anthonylhill/PiLoader/Photos/PCB.jpg

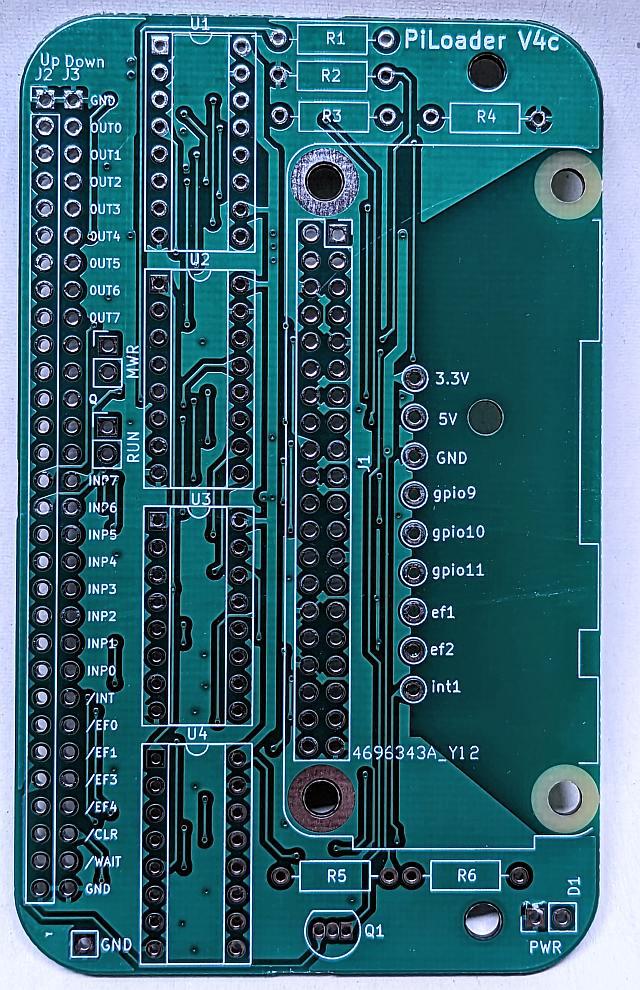
Photos/PCB.jpg
