anthonylhill/PiLoader/Photos/localmode.jpg

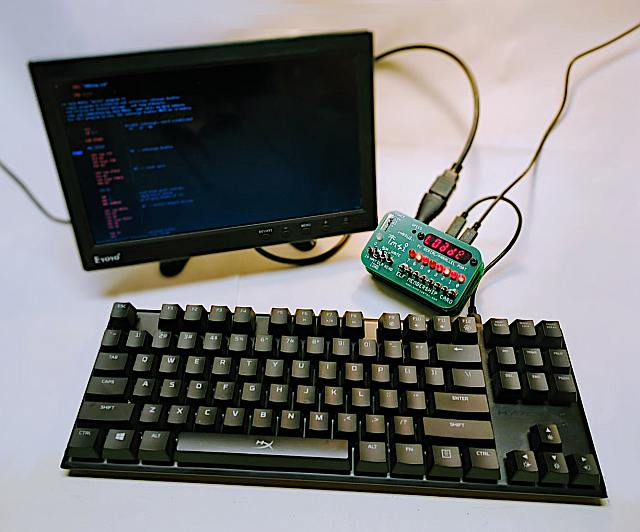
Photos/localmode.jpg
