anthonylhill/PiLoader/README.md

# PiZero Adapter for Lee Hart's Membership Card
### Project Web Page :  [ http://anthonylhill.github.io ](http://anthonylhill.github.io)
<table> 
    <tr>
        <td>System</td><td>Lee Hart's Membership Card</td>
    </tr>    
    <tr>
        <td>Processor</td><td>CDP1802 1.8 or 4 MHz</td>
    </tr>
    <tr>
        <td>Raspberry Pi</td><td>Zero,  Zero W, Zero 2 W</td>
    </tr>
    <tr>
        <td>Software</td><td>1802 Loader Program</td>
    </tr>
</table>

Software README.TXT :   https://github.com/anthonylhill/PiLoader/blob/main/Software/README.TXT </br>
<B>Tags</B> : CDP1802 eclectic retro mishmash fusion retro-futurism anachronism
