anthonylhill/PiLoader/Photos/CPUonly.jpg

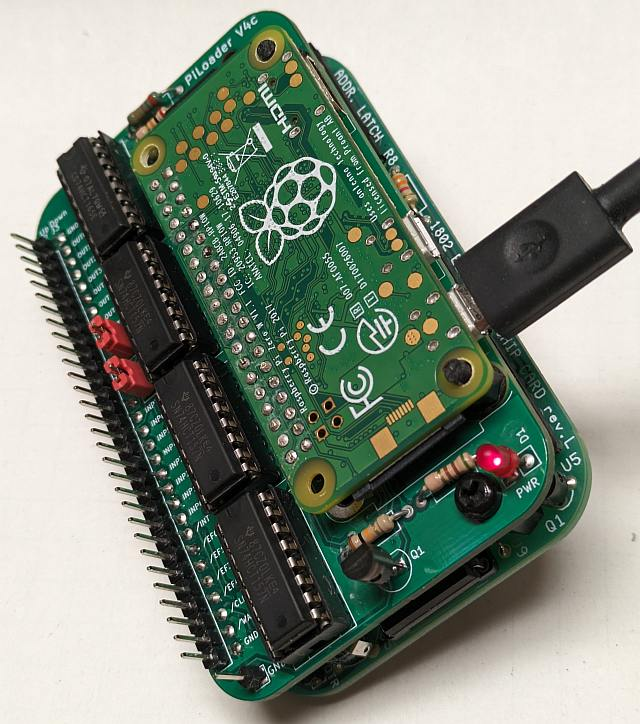
Photos/CPUonly.jpg
