anthonylhill/PiLoader/Photos/Front.jpg

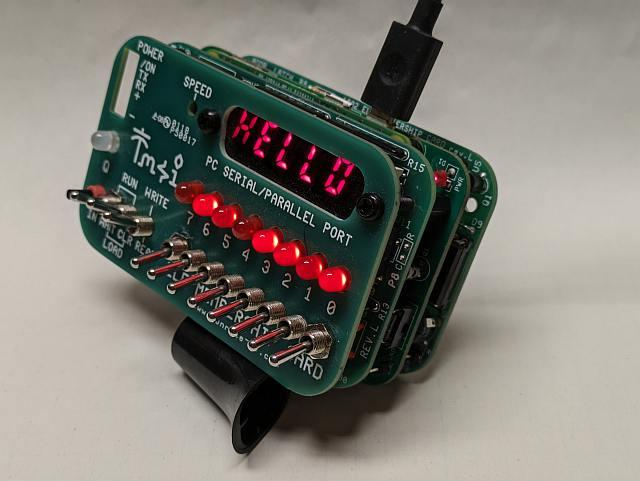
Photos/Front.jpg
