anthonylhill/PiLoader/Photos/screenshot.jpg

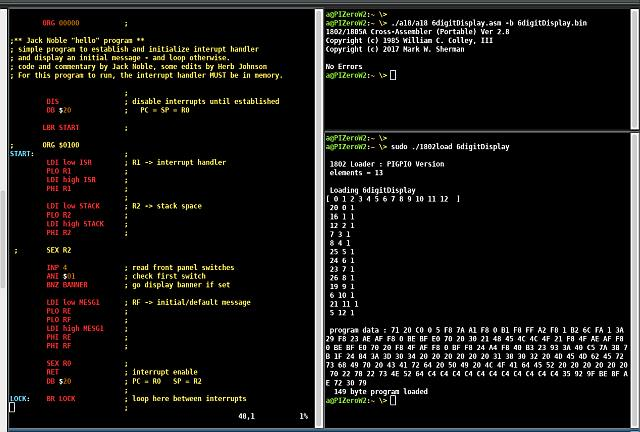
Photos/screenshot.jpg
