anthonylhill/PiLoader/Photos/Side.jpg

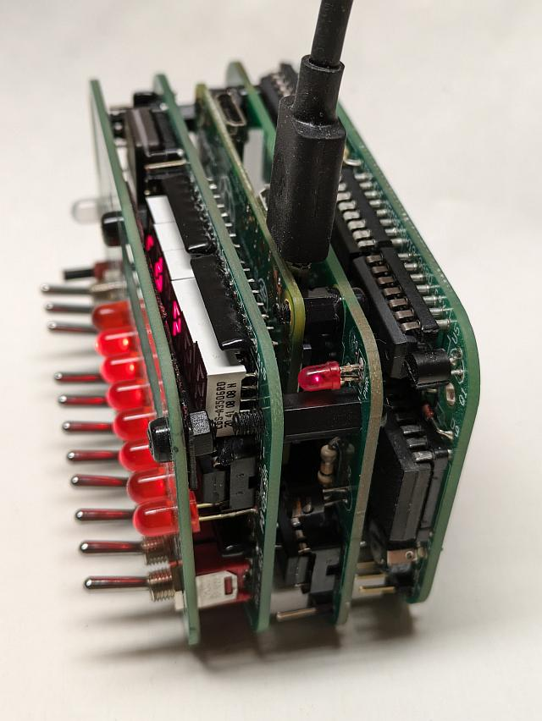
Photos/Side.jpg
