anthonylhill/PiLoader/Photos/TopView.jpg

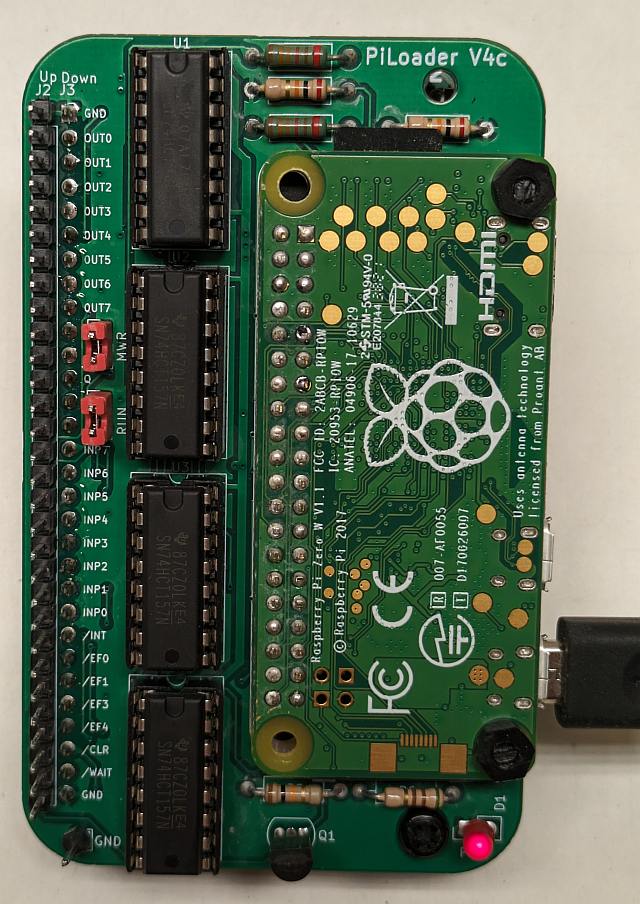
Photos/TopView.jpg
