anthonylhill/PiLoader/schematic.pdf

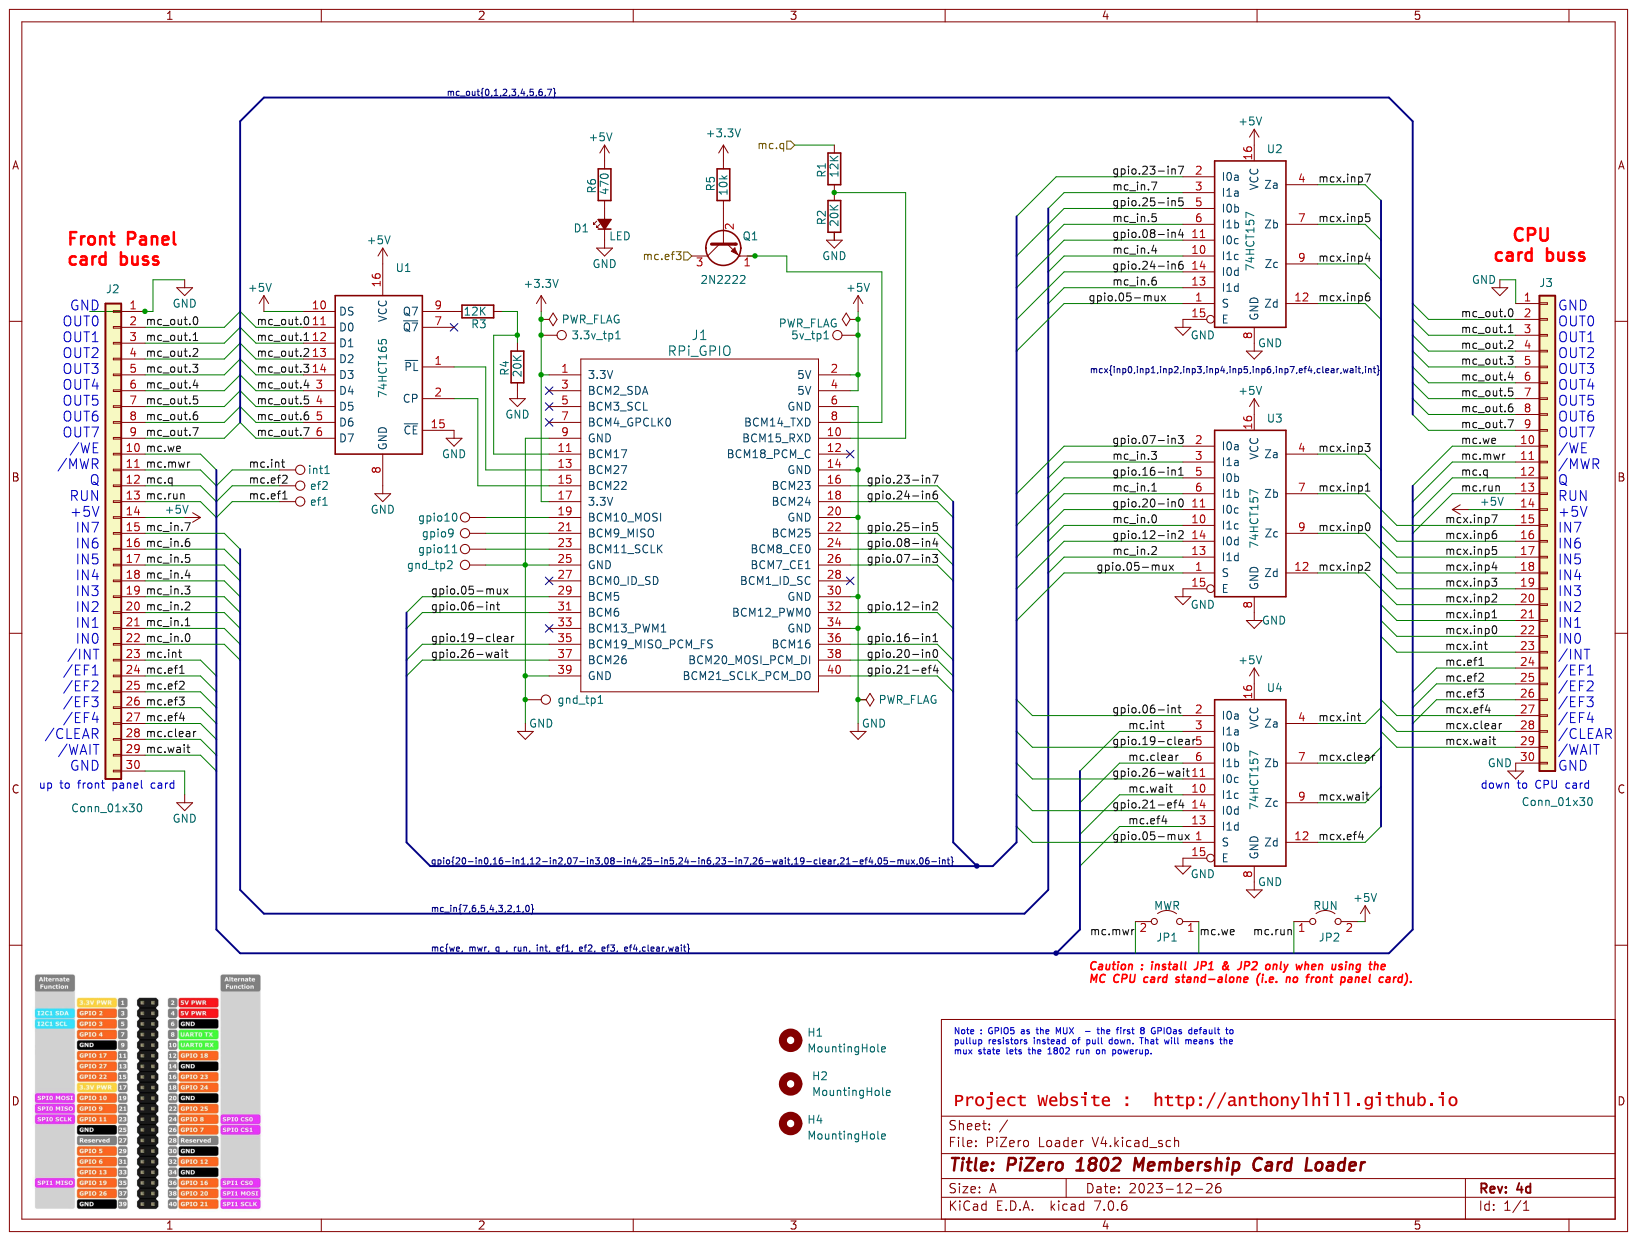
[picture p12: page 1]
