anthonylhill/PiLoader/KiCAD 7.0 Files/PiZero Loader V4.kicad_pcb

## KiCad design KiCAD 7.0 Files/PiZero Loader V4.kicad_pcb (2023-06-16)

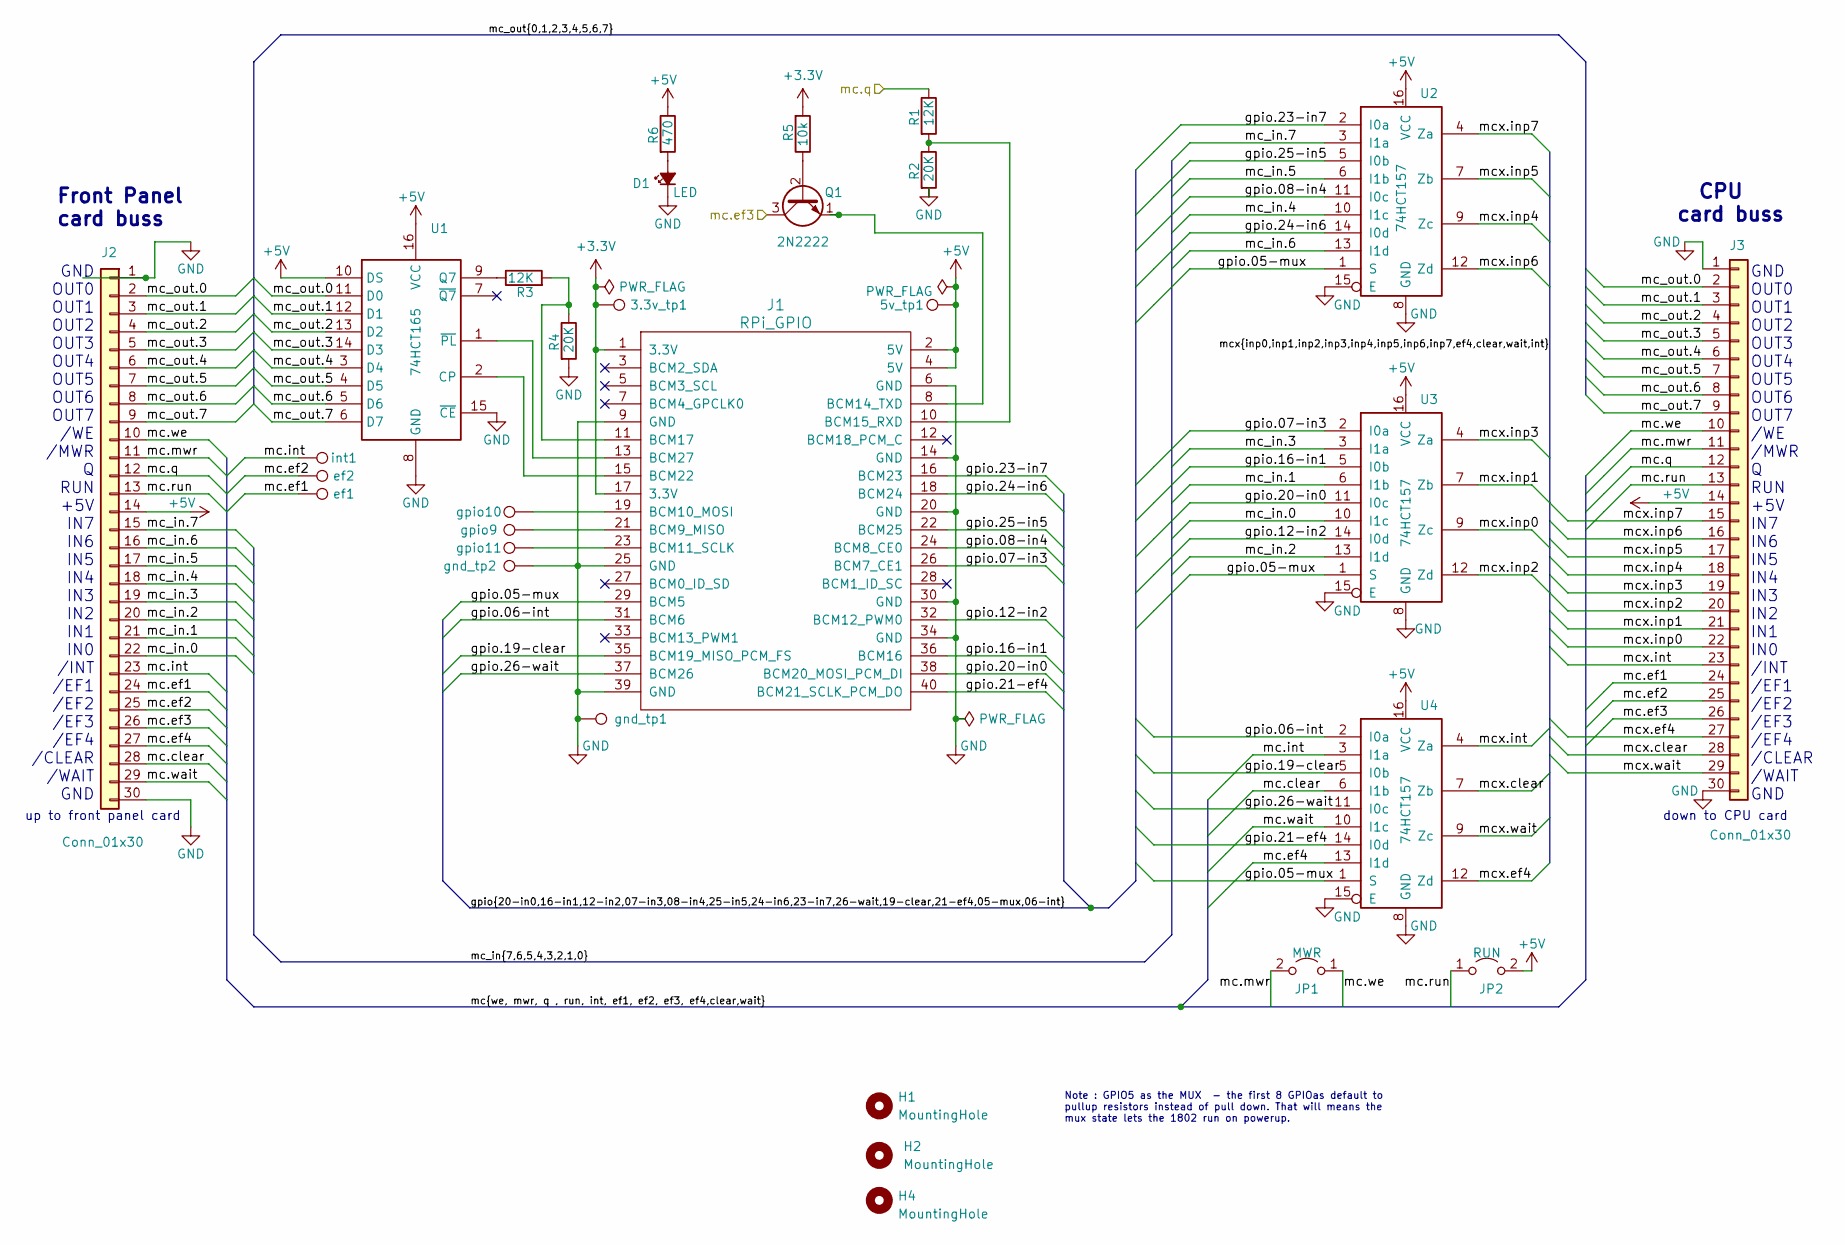
[picture p13: schematic PiZero Loader V4.kicad_sch, PiZero 1802 Membership Card Loader]

Parts:
3.3v_tp1, 5v_tp1: TestPoint; TestPoint_THTPad_D2.0mm_Drill1.0mm
D1: LED; PinHeader_1x02_P2.54mm_Vertical
H1, H2, H4: MountingHole; MountingHole_3.2mm_M3
J1: RPi_GPIO; Raspberry_Pi_Zero_Socketed_THT_FaceDown_MountingHoles
J2: Conn_01x30; PinHeader_1x30_P2.54mm_Vertical
J3: Conn_01x30; PinSocket_1x30_P2.54mm_Vertical
JP1: MWR; PinHeader_1x02_P2.54mm_Vertical
JP2: RUN; PinHeader_1x02_P2.54mm_Vertical
Q1: 2N2222; TO-92_Inline
R1, R3: 12K; R_Axial_DIN0207_L6.3mm_D2.5mm_P10.16mm_Horizontal
R2, R4: 20K; R_Axial_DIN0207_L6.3mm_D2.5mm_P10.16mm_Horizontal
R5: 10k; R_Axial_DIN0207_L6.3mm_D2.5mm_P10.16mm_Horizontal
R6: 470; R_Axial_DIN0207_L6.3mm_D2.5mm_P10.16mm_Horizontal
U1: 74HCT165; DIP-16_W7.62mm_Socket
U2, U3, U4: 74HCT157; DIP-16_W7.62mm_Socket
ef1, ef2: TestPoint; TestPoint_THTPad_D2.0mm_Drill1.0mm
gnd_tp1: TestPoint; TestPoint_THTPad_D2.0mm_Drill1.0mm
gnd_tp2: TestPoint; TestPoint_THTPad_2.0x2.0mm_Drill1.0mm
gpio9, gpio10, gpio11: TestPoint; TestPoint_THTPad_D2.0mm_Drill1.0mm
int1: TestPoint; TestPoint_THTPad_D2.0mm_Drill1.0mm

Connections:
+3.3V: 3.3v_tp1.1, J1.1 (3.3V), J1.17 (3.3V), R5.2
+5V: 5v_tp1.1, J1.2 (5V), J1.4 (5V), J2.14, J3.14, JP2.2 (B), R6.1, U1.10 (DS), U1.16 (VCC), U2.16 (VCC), U3.16 (VCC), U4.16 (VCC)
/gpio.05-mux: J1.29 (BCM5), U2.1 (S), U3.1 (S), U4.1 (S)
/gpio.06-int: J1.31 (BCM6), U4.2 (I0a)
/gpio.07-in3: J1.26 (BCM7_CE1), U3.2 (I0a)
/gpio.08-in4: J1.24 (BCM8_CE0), U2.11 (I0c)
/gpio.12-in2: J1.32 (BCM12_PWM0), U3.14 (I0d)
/gpio.16-in1: J1.36 (BCM16), U3.5 (I0b)
/gpio.19-clear: J1.35 (BCM19_MISO_PCM_FS), U4.5 (I0b)
/gpio.20-in0: J1.38 (BCM20_MOSI_PCM_DI), U3.11 (I0c)
/gpio.21-ef4: J1.40 (BCM21_SCLK_PCM_DO), U4.14 (I0d)
/gpio.23-in7: J1.16 (BCM23), U2.2 (I0a)
/gpio.24-in6: J1.18 (BCM24), U2.14 (I0d)
/gpio.25-in5: J1.22 (BCM25), U2.5 (I0b)
/gpio.26-wait: J1.37 (BCM26), U4.11 (I0c)
/mc.clear: J2.28, U4.6 (I1b)
/mc.ef1: J2.24, J3.24, ef1.1
/mc.ef2: J2.25, J3.25, ef2.1
/mc.ef3: J2.26, J3.26, Q1.3 (C)
/mc.ef4: J2.27, U4.13 (I1d)
/mc.int: J2.23, U4.3 (I1a), int1.1
/mc.mwr: J2.11, J3.11, JP1.2 (B)
/mc.q: J2.12, J3.12, R1.1
/mc.run: J2.13, J3.13, JP2.1 (A)
/mc.wait: J2.29, U4.10 (I1c)
/mc.we: J2.10, J3.10, JP1.1 (A)
/mc_in.0: J2.22, U3.10 (I1c)
/mc_in.1: J2.21, U3.6 (I1b)
/mc_in.2: J2.20, U3.13 (I1d)
/mc_in.3: J2.19, U3.3 (I1a)
/mc_in.4: J2.18, U2.10 (I1c)
/mc_in.5: J2.17, U2.6 (I1b)
/mc_in.6: J2.16, U2.13 (I1d)
/mc_in.7: J2.15, U2.3 (I1a)
/mc_out.0: J2.2, J3.2, U1.11 (D0)
/mc_out.1: J2.3, J3.3, U1.12 (D1)
/mc_out.2: J2.4, J3.4, U1.13 (D2)
/mc_out.3: J2.5, J3.5, U1.14 (D3)
/mc_out.4: J2.6, J3.6, U1.3 (D4)
/mc_out.5: J2.7, J3.7, U1.4 (D5)
/mc_out.6: J2.8, J3.8, U1.5 (D6)
/mc_out.7: J2.9, J3.9, U1.6 (D7)
/mcx.clear: J3.28, U4.7 (Zb)
/mcx.ef4: J3.27, U4.12 (Zd)
/mcx.inp0: J3.22, U3.9 (Zc)
/mcx.inp1: J3.21, U3.7 (Zb)
/mcx.inp2: J3.20, U3.12 (Zd)
/mcx.inp3: J3.19, U3.4 (Za)
/mcx.inp4: J3.18, U2.9 (Zc)
/mcx.inp5: J3.17, U2.7 (Zb)
/mcx.inp6: J3.16, U2.12 (Zd)
/mcx.inp7: J3.15, U2.4 (Za)
/mcx.int: J3.23, U4.4 (Za)
/mcx.wait: J3.29, U4.9 (Zc)
GND: D1.1 (K), J1.6 (GND), J1.9 (GND), J1.14 (GND), J1.20 (GND), J1.25 (GND), J1.30 (GND), J1.34 (GND), J1.39 (GND), J2.1, J2.30, J3.1, J3.30, R2.2, R4.2, U1.8 (GND), U1.15 (~CE), U2.8 (GND), U2.15 (E), U3.8 (GND), U3.15 (E), U4.8 (GND), U4.15 (E), gnd_tp1.1, gnd_tp2.1
unnamed: D1.2 (A), R6.2
unnamed: J1.21 (BCM9_MISO), gpio9.1
unnamed: J1.19 (BCM10_MOSI), gpio10.1
unnamed: J1.23 (BCM11_SCLK), gpio11.1
unnamed: J1.8 (BCM14_TXD), Q1.1 (E)
unnamed: J1.10 (BCM15_RXD), R1.2, R2.1
unnamed: J1.11 (BCM17), R3.2, R4.1
unnamed: J1.15 (BCM22), U1.2 (CP)
unnamed: J1.13 (BCM27), U1.1 (~PL)
unnamed: Q1.2 (B), R5.1
unnamed: R3.1, U1.9 (Q7)

Notes on the sheet:
Front Panel card buss
GND OUT0 OUT1 OUT2 OUT3 OUT4 OUT5 OUT6 OUT7 /WE /MWR Q RUN +5V IN7 IN6 IN5 IN4 IN3 IN2 IN1 IN0 /INT /EF1 /EF2 /EF3 /EF4 /CLEAR /WAIT GND
Note : GPIO5 as the MUX - the first 8 GPIOas default to pullup resistors instead of pull down. That will means the mux state lets the 1802 run on powerup.
CPU card buss
up to front panel card
down to CPU card

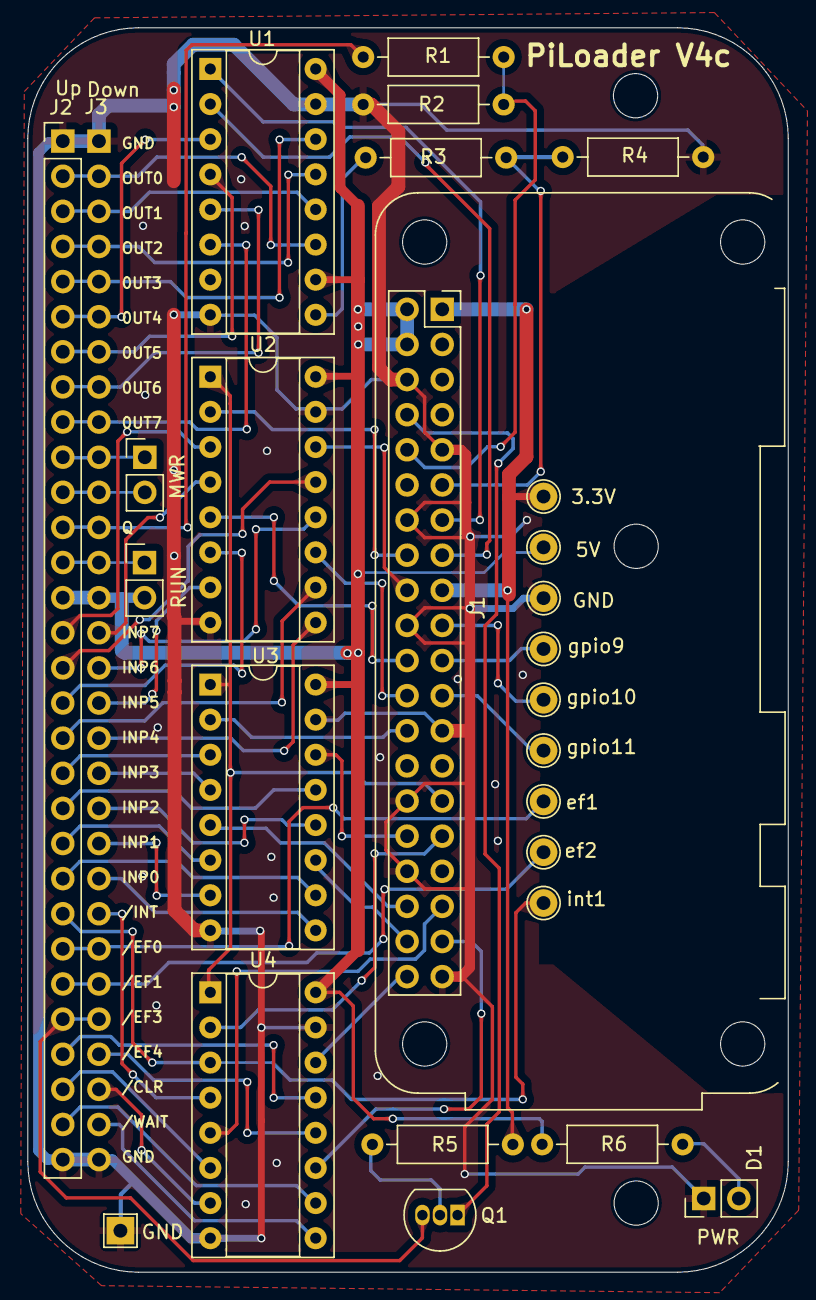
[picture p14: board PiZero Loader V4.kicad_pcb from above]

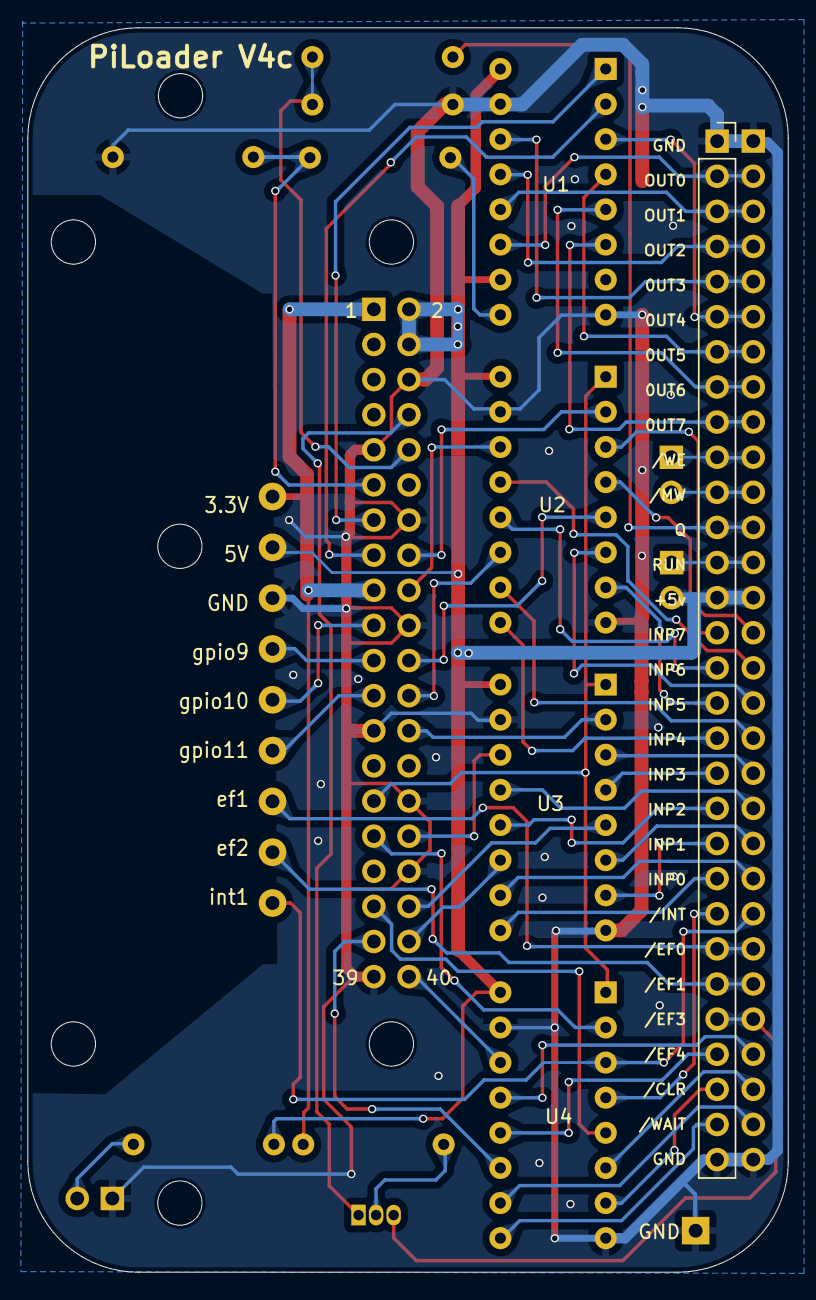
[picture p15: board PiZero Loader V4.kicad_pcb from below]

Board: 2 copper layers, 55.0 x 90.0 mm, 30 parts (2 on the bottom side), 66 nets.
