anthonylhill/PiLoader/(commit log)

2023-06-16 added KiCAD files
    [PiZero Loader V4.kicad_pcb, PiZero Loader V4.kicad_sch]
2023-06-17 Create BOM and Assembly Instructions.pdf
2023-06-17 updated BOM and Assembly Instructions
2023-06-17 Update BOM and Assembly Instructions.pdf
2023-10-20 missing files
    added loader_gpio.h and loader_utils.h
    [loader_gpio.h]
2023-10-20 additional source files
    - added a small README file to the software folder
    - added gpio bit test programs
    - added some example 1802 assembler files
2023-10-20 Update 1802load.c
    - fixed typo in previous change
    [1802load.c]
2023-10-20 Update BOM and Assembly Instructions.pdf
    added a couple of notes to the software section
2023-11-02 added a clean option to the makefile
    clean option deletes all .LST files and touches all source files to force a recompile or assemble on next invocation of make
2023-11-03 added a note about /ON grounding
    the RUN jumper on the adapter card will bypass the front panel /ON signal and always send a RUN signal to the CPU card. However on front panels rev L and beyond, you still need the jumper on the front panel card if you want to enable the data LEDs and 7 segment displays.
2023-12-05 added -x switch
    Added -x to cause loader to simply jump to the load/execute address without loading any code. Useful for testing or jumping to ROM in high memory.
2023-12-05 bug fix and misc cleanups
    fixed sigHandler: Unhandled signal 11, terminating crash introduced in previous update
    [1802load.c]
2023-12-24 added load without execute
    - added a switch to allow loading only - processor is left in LOAD mode and not put into RUN mode after the load
    - general cleanup of the command line switches with some reassignment of functionality
    - added a "stop the 1802" mode
2023-12-24 UI improvements
    - added user confirmation in verbose mode before proceeding
    - added switch to default user answer to "Yes"
    - upgrade checking of hex input values to limit valid inputs to 4 characters
2023-12-24 UI updates
    - reworked verbose mode to better describe actions that will be taken
    [1802load.c]
2023-12-24 Update BOM and Assembly Instructions.pdf
    add introduction section - mostly borrowed from project's github html webpage
2023-12-25 added warning not to install JP1
    if JP1 is installed and the front panel READ/WRTIE swtich is set to the READ position then the 1802 /MWR pin gets shorted to +5V
    [PiZero Loader V4.kicad_sch, PiZero Loader V4.sch]
2023-12-26 JP1 & JP2 assembly instructions changed
    = added wording to the assembly instructions and schematic stating that JP1 and JP2 are only for use with a standalone CPU card (i.e. when not using the MC Front Panel card).
    [PiZero Loader V4.kicad_sch]
